agricgear/agricIO/hardware/main-schema.pdf

1

2

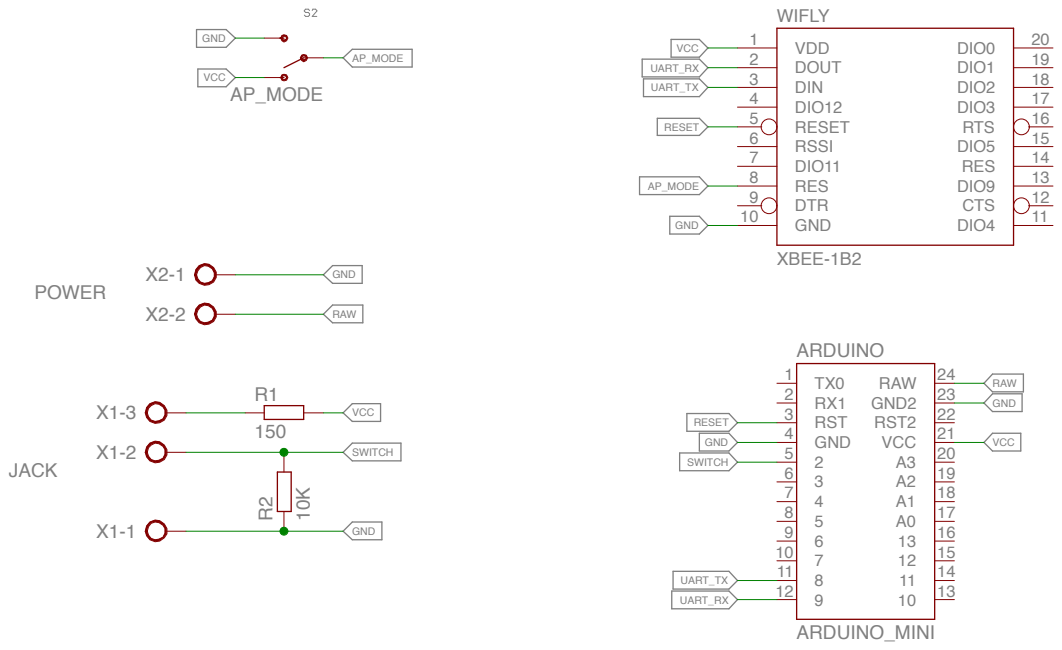
[picture p3: page 1]
JACK; ARDUINO_MINI; POWER; XBEE-1B2; AP_MODE; ARDUINO 2; 20 GND 4; GND2; 23 RAW; RST; RST2; VCC; WIFLY; VDD; DOUT; DIN; DIO12; RESET; RSSI; DIO11; RES; DTR; GND 10; DIO4; 11 CTS; 12 DIO9; 13 RES; 14 DIO5; 15 RTS; 16 DIO3; 17 DIO2; 18 DIO1; 19 DIO0; UART_RX; UART_TX; GND; RAW; SWITCH SWITCH; ABCD
