agricgear/agricIO/hardware/main-board.pdf

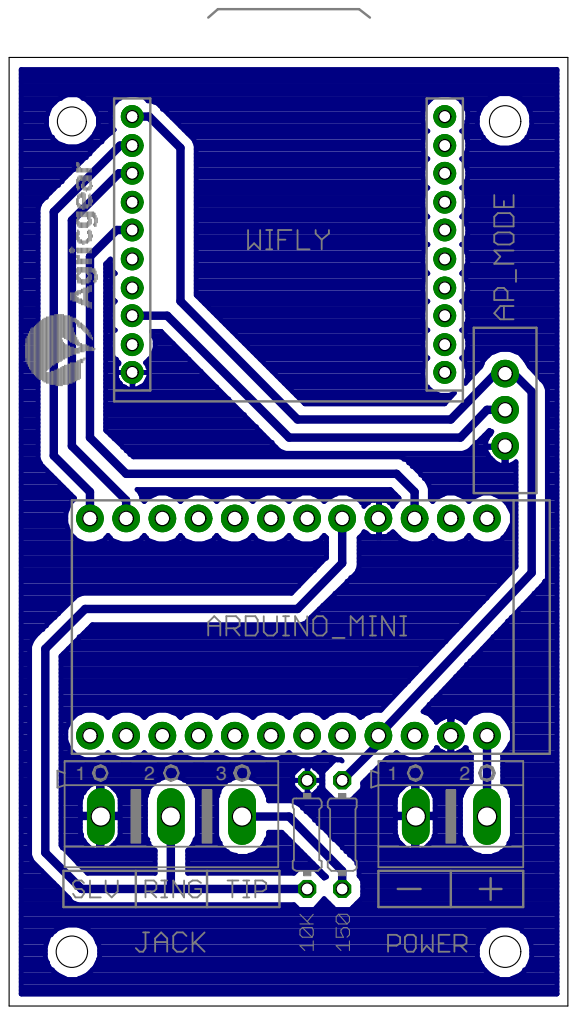
[picture p4: page 1]
