agricgear/agricIO/hardware/main.brd

## EAGLE design hardware/main.brd (2013-11-02)

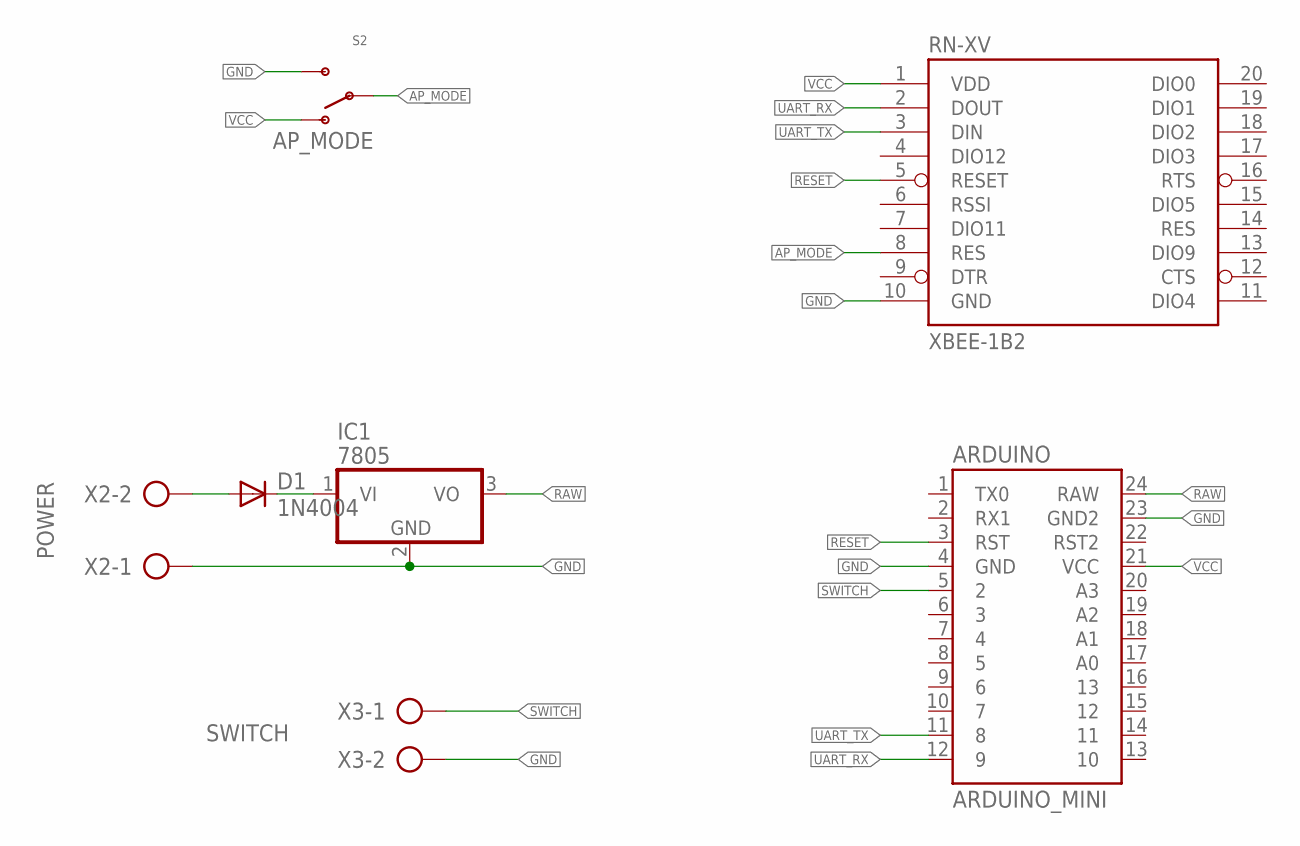
[picture p5: schematic main.sch]

Parts:
ARDUINO: ARDUINO_MINI
D1: 1N4004; DO41-10
IC1: 7805; TO220V
RN-XV: XBEE-1B2; XBEE-SILK
S2: AP_MODE; SWITCH-SPDT
X2: POWER; AK500/2
X3: SWITCH; AK500/2

Connections:
AP_MODE: RN-XV.8 (RES), S2.2
GND: ARDUINO.4 (GND), ARDUINO.23 (GND2), IC1.2 (GND), RN-XV.10 (GND), S2.3 (S), X2.1, X3.2
unnamed: D1.A, X2.2
unnamed: D1.C, IC1.1 (VI)
RAW: ARDUINO.24 (RAW), IC1.3 (VO)
RESET: ARDUINO.3 (RST), RN-XV.5 (RESET)
SWITCH: ARDUINO.5 (2), X3.1
UART_RX: ARDUINO.12 (9), RN-XV.2 (DOUT)
UART_TX: ARDUINO.11 (8), RN-XV.3 (DIN)
VCC: ARDUINO.21 (VCC), RN-XV.1 (VDD), S2.1 (O)

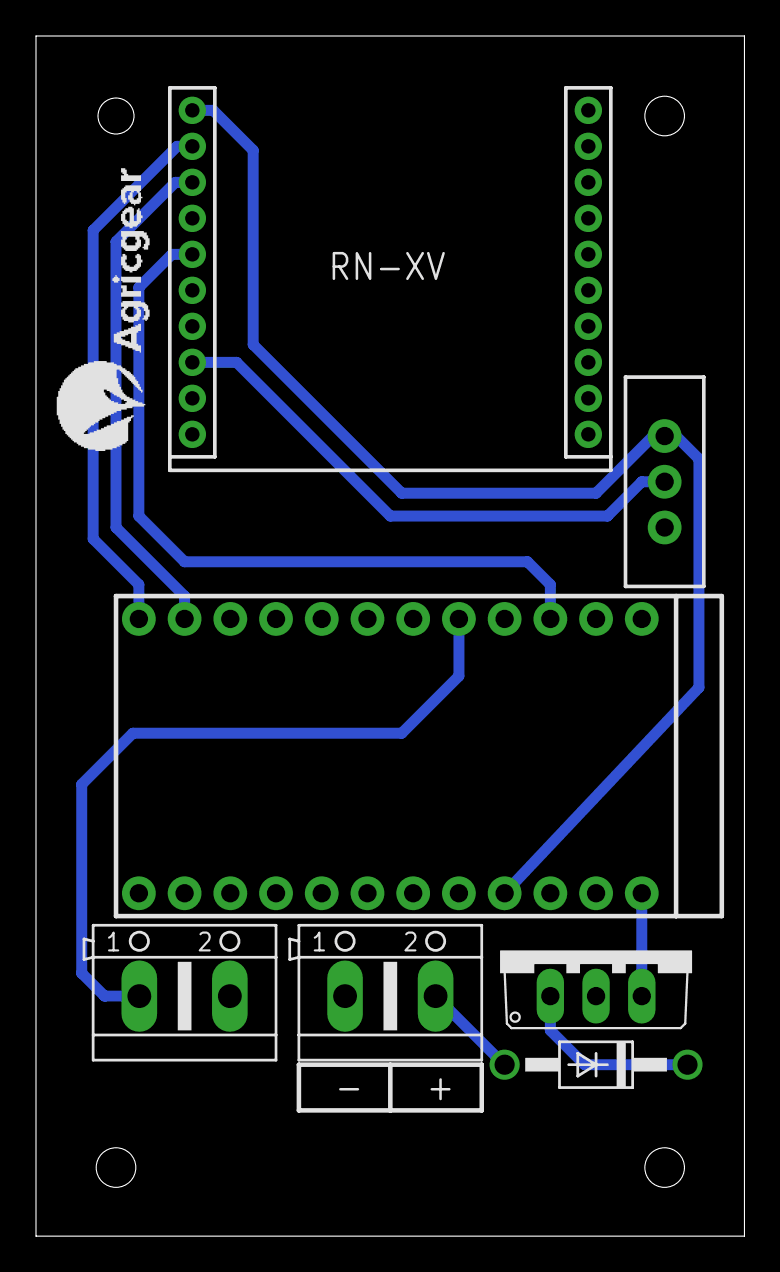
[picture p6: board main.brd from above]

Board: 2 copper layers, 39.4 x 66.7 mm, 8 parts (0 on the bottom side), 10 nets.

Other parts of the board:
U$4: LOGO_AGROGUIA_SILK
