agricgear/agricIO/(commit log)

2013-06-12 Added hardware files in EagleCad format
    [main.brd, main.sch]
2013-06-12 Added firmware as Arduino sketch
2013-06-12 Added A4 frame to schema
    [main.sch]
2013-06-12 Added PDF preview of schema and board
2013-07-08 Añadidos cambios sobre el hardware y el firmware del prototipo final.
    [main.brd, main.sch]
2013-07-08 Añadido fichero backup de texto con los valores configurados en el modulo Wifly RN-XV
    [wifly_config_backup.txt]
2013-11-02 - Añadido PSD usado para crear PCB en casa - Actualizado main.brd a version de eagle 6.5.0
    [main.brd]
