agricgear/agricIO/(notices)

Notices in the files:
parts and their libraries:
SparkFun-Electromechanical: Licensing: CC v3.0 Share-Alike You are welcome to use this library for commercial purposes.
